Waz-Cpt/levo-tcu-protocol/hardware/diagrams/Rosenberg Connector.png

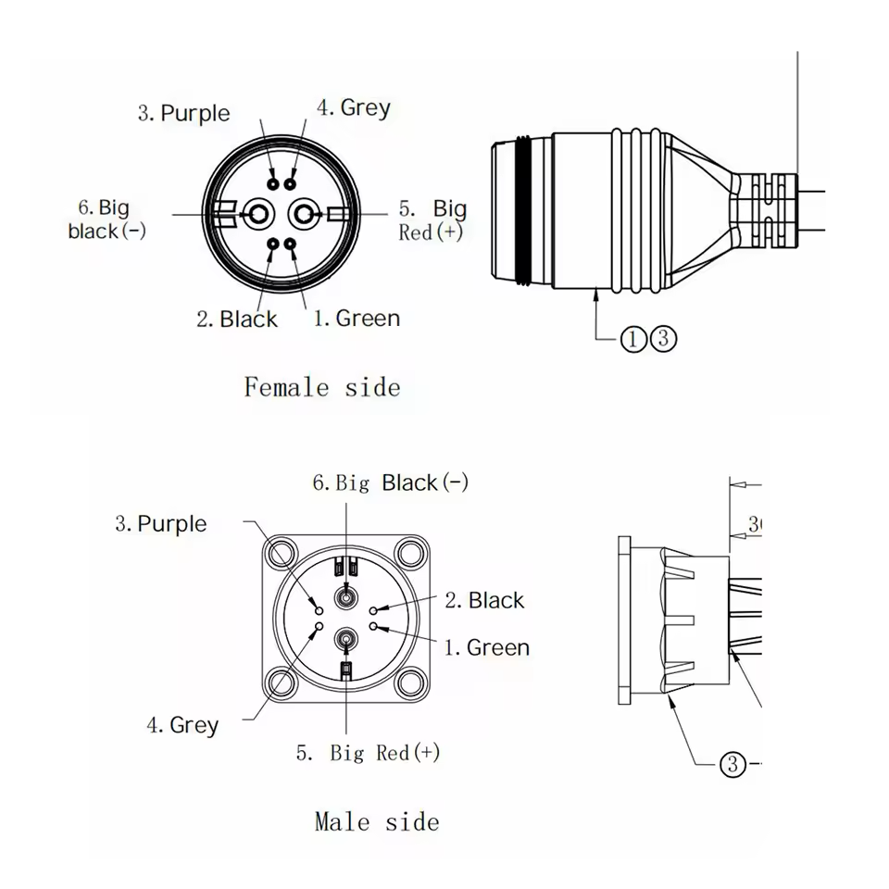
hardware/diagrams/Rosenberg Connector.png
