Waz-Cpt/levo-tcu-protocol/hardware/3d-print/base.stl

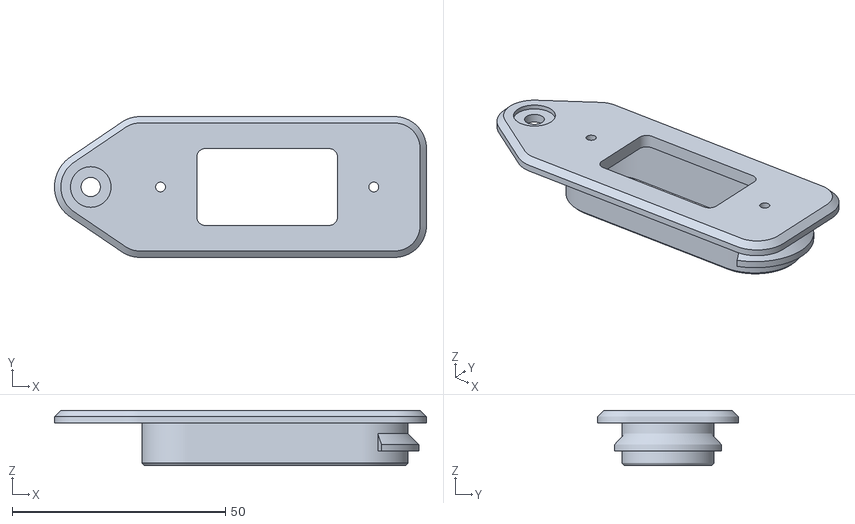
[picture p4: CAD file, 2026-10-28]
hardware/3d-print/base.stl
87.2 x 33.0 x 13.0
