Waz-Cpt/levo-tcu-protocol/hardware/3d-print/shroud.stl

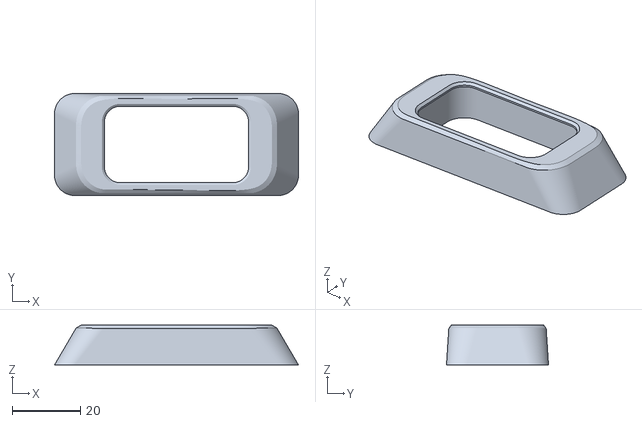
[picture p5: CAD file, 2026-10-28]
hardware/3d-print/shroud.stl
71.7 x 30.0 x 11.7
