Waz-Cpt/levo-tcu-protocol/docs/images/test-bike.jpg

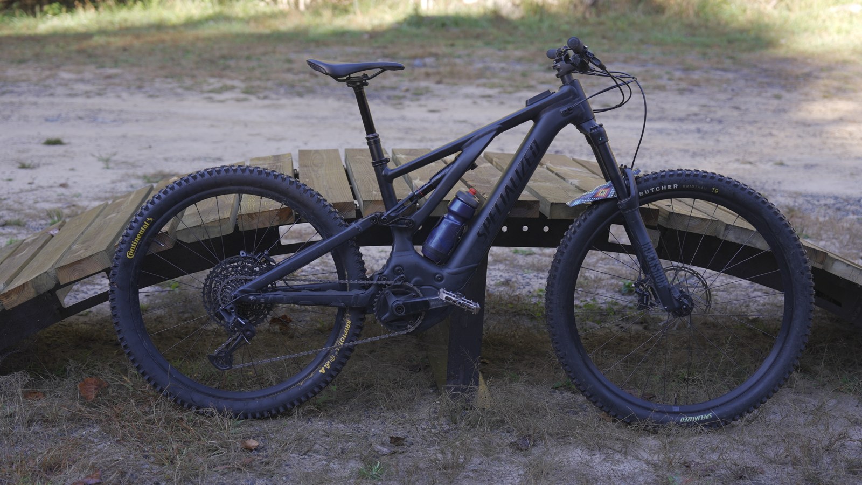
docs/images/test-bike.jpg
