Waz-Cpt/levo-tcu-protocol/(commit log)

2026-10-28 Publish Levo TCU protocol research and reference controller
    [base.stl, partitions.csv, shroud.stl]
2026-11-03 Rosenberg Connector for the Battery
    Formal image of the Rosenberg Connector for the battery.
